csosborn/roboat/tools/README.md

# Deploy tools

Code reaches the boat only through git: commit on the laptop, then deploy that commit. Nothing is edited on the Pi or the RP2040 directly, so what's running is always an identifiable commit. The RP2040 reports its commit in every status message (the `rp2040_status` measurement in InfluxDB).

```bash
tools/deploy.sh            # deploy HEAD
tools/deploy.sh some-branch
tools/deploy.sh --no-flash # update the Pi but leave the RP2040 alone
tools/deploy.sh --flash    # reflash the RP2040 even if its files didn't change
```

Flashing resets the RP2040, but the Pi's power stays on through the reset (see the power safety rules in `Compute.md`). `deploy.sh` fails if the Pi rebooted during the deploy. (Until 2026-10-21 the Pi's supply dropped out during an RP2040 reset, and deploys used a `--flash-halt` option to shut the Pi down first; it's gone, because with the new supply a halted Pi would stay halted.)

`deploy.sh` runs `check.sh` (host tests plus a MicroPython compile of every firmware file), pushes the commit to the Pi's `deployed` branch over SSH, and runs `pi_apply.sh` there. That script:

- installs any systemd unit that differs from the installed copy, and reloads systemd;
- updates the monitor's virtualenv if its requirements changed, and restarts the monitor if its code or unit changed;
- runs `docker-compose up` if the TIG stack's configuration changed;
- flashes the RP2040 with `rp2040_flash.py` if `src/micro` changed. It flashes over the serial link that carries telemetry (`/dev/ttyAMA3`), stopping the monitor for the duration: the firmware's `maintenance` command moves its REPL onto that link. If the board doesn't respond, for example because its firmware predates serial deploys, it falls back to USB.

The flash stages every changed file on the RP2040 and verifies it before replacing anything, then resets the board and waits for its boot status message to report the new commit. If it fails part way, the board's files are unchanged; the interrupted firmware resumes on its own within 15 minutes, or immediately with a reset.

## Setting up a new RP2040

The firmware runs on stock MicroPython; no custom build is needed. Flash the release for the Adafruit Feather RP2040 (https://micropython.org/download/ADAFRUIT_FEATHER_RP2040/, currently v1.29.0) over USB: hold BOOTSEL while plugging it in, and copy the `.uf2` file to the drive that appears. `tools/requirements-dev.txt` pins `mpy-cross` to the same version, so `check.sh` compiles with the board's compiler; keep the two in step when upgrading.

A blank board has no firmware to answer the serial link's maintenance command, so its first install goes over USB, most easily from a laptop, before the board goes into the boat:

```bash
tools/.venv/bin/python tools/rp2040_flash.py --version "$(git rev-parse --short=12 HEAD)" --port /dev/cu.usbmodemXXXX --no-boot-check
```

Later deploys go over the serial link. MicroPython keeps the board's filesystem when it's reflashed, so a used board may still hold old files; they use up space the telemetry log needs, so check with `mpremote fs ls`.

## One-time Pi setup

The Pi's checkout at `~/roboat` must accept pushes to its checked-out branch, and refuse them if someone has edited files there:

```bash
git -C ~/roboat config receive.denyCurrentBranch updateInstead
git -C ~/roboat switch -c deployed
```

The secrets in `src/pi/TIG/*.env` stay on the Pi and are never deployed; see `src/pi/TIG/setup.md`.
