csosborn/roboat/take1/Navigation.md

# Roboat Navigation Module

## Hardware: GPS and IMU

GPS: [Adafruit MTK3339 Module](https://www.adafruit.com/product/790)

IMU: [Adafruit NXP 9-DOF IMU Module](https://www.adafruit.com/product/3463)

### Notes

The [TinyGPSPlus module](http://arduiniana.org/libraries/tinygpsplus/) ([v0.95](https://github.com/mikalhart/TinyGPSPlus/releases/tag/v0.95)) is used for parsing NMEA83 sentences from the GPS receiver.
