csosborn/roboat/take1/Pilot.md

# Roboat Pilot Module

## Hardware: Teensy 3.6

### Notes

The navigator module will need some help in the form of IMU sensor fusion. Consider using [the Madgwick AHRS algorithm](https://github.com/PaulStoffregen/MadgwickAHRS).
