csosborn/roboat/hardware/avionics/avionics.kicad_pcb

## KiCad design hardware/avionics/avionics.kicad_pcb (2026-11-11)

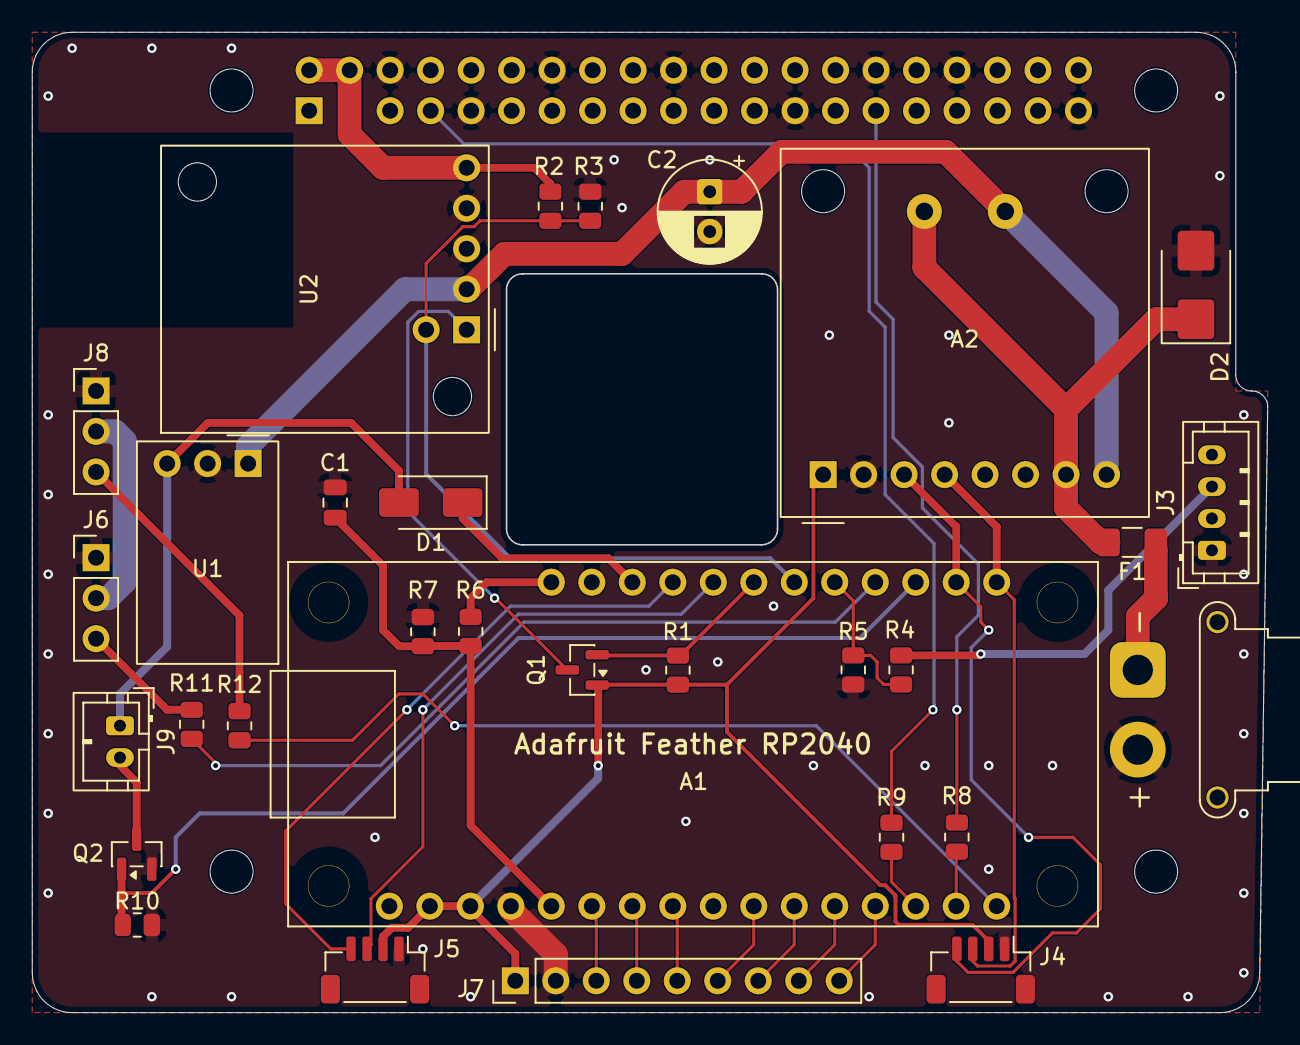
[picture p3: board avionics.kicad_pcb from above]

Board: 2 copper layers, 77.5 x 61.5 mm, 36 parts (1 on the bottom side), 37 nets.

Parts:
A1: Feather RP2040; Adafruit-Feather-RP2040
A2: INA260 breakout; Adafruit_INA260_Breakout
C1: 0.1u; C_0805_2012Metric
C2: 33u 50V; CP_Radial_D6.3mm_P2.50mm
D1: SS12; D_SMA
D2: SMBJ18A; D_SMB
F1: 0685T3000-01; Fuse_1206_3216Metric_Pad1.42x1.75mm_HandSolder
H1, H2, H3, H4: MountingHole_2.7mm_M2.5
J1: Load input; AMASS_XT30PW-F_1x02_P2.50mm_Horizontal
J2: Raspberry Pi header; PinSocket_2x20_P2.54mm_Vertical_NoPin3
J3: VE.Direct; JST_PH_B4B-PH-K_1x04_P2.00mm_Vertical
J4: STEMMA QT I2C1; JST_SH_BM04B-SRSS-TB_1x04-1MP_P1.00mm_Vertical
J5: STEMMA QT I2C0; JST_SH_BM04B-SRSS-TB_1x04-1MP_P1.00mm_Vertical
J6: ESC; PinHeader_1x03_P2.54mm_Vertical
J7: Spare GPIO; PinHeader_1x09_P2.54mm_Vertical
J8: Rudder servo; PinHeader_1x03_P2.54mm_Vertical
J9: Drive relay input; JST_PH_B2B-PH-K_1x02_P2.00mm_Vertical
Q1, Q2: BSS138; SOT-23
R1, R2, R4: 10k; R_0805_2012Metric
R3, R5: 15k; R_0805_2012Metric
R6, R7, R10: 100k; R_0805_2012Metric
R8, R9, R11, R12: 1k; R_0805_2012Metric
U1: D24V7F5; Pololu_D24V7F5
U2: D36V28F5; Pololu_D36V28F5

Connections:
/3V3: A1.2 (3.3V), A1.3 (3.3V), A2.1 (VCC), J4.2, J5.2, J7.1, Q1.1 (G), R1.1
/5V_AON: D1.2 (A), J9.1, U1.3 (VOUT)
/5V_PI: J2.2, J2.4, R2.1, U2.5 (VOUT)
/BEC_5V: J6.2, J8.2
/DRIVE_PWM: A1.20 (D6/GPIO8), R11.1
/DRIVE_PWM_R: J6.3, R11.2
/DRIVE_PWR_EN: A1.19 (D5/GPIO7), Q2.1 (G), R10.1
/DRIVE_RELAY_N: J9.2, Q2.3 (D)
/FEATHER_USB: A1.26 (Vbus), D1.1 (K)
/I2C0_SCL: A1.25 (D13/GPIO13), J5.4
/I2C0_SDA: A1.24 (D12/GPIO12), J5.3
/I2C1_SCL: A1.18 (SCL/GPIO3), A2.3 (SCL), J4.4
/I2C1_SDA: A1.17 (SDA/GPIO2), A2.4 (SDA), J4.3
/LIPO_BAT: A1.28 (VBat), R6.1
/LIPO_SENSE: A1.5 (A0/GPIO26), C1.1, R6.2, R7.1
/LOAD_FUSED: A2.7 (VIN+), D2.1 (K), F1.2
/LOAD_IN: F1.1, J1.1
/PI_EN: Q1.3 (D), U2.1 (EN)
/PI_EN_CTRL: A1.23 (D11/GPIO11), Q1.2 (S), R1.2
/PI_LINK_RX: A1.14 (RX/CS/GPIO1), R9.1
/PI_LINK_RX_R: J2.7, R9.2
/PI_LINK_TX: A1.15 (TX/GPIO0), R8.1
/PI_LINK_TX_R: J2.29, R8.2
/PI_PG: A1.22 (D10/GPIO10), R2.2, R3.1, U2.6 (PG)
/RUDDER_PWM: A1.16 (D4/GPIO6), R12.1
/RUDDER_PWM_R: J8.3, R12.2
/SPARE_A1: A1.6 (A1/GPIO27), J7.3
/SPARE_A2: A1.7 (A2/GPIO28), J7.4
/SPARE_A3: A1.8 (A3/GPIO29), J7.5
/SPARE_D25: A1.10 (D25/GPIO25), J7.6
/SPARE_MISO: A1.13 (MISO/GPIO20), J7.9
/SPARE_MOSI: A1.12 (MOSI/GPIO19), J7.8
/SPARE_SCK: A1.11 (SCK/GPIO18), J7.7
/VBUS_12V: A2.8 (VIN-), C2.1, U1.1 (VIN), U2.2 (VIN)
/VE_TX: J3.3, R4.1
/VE_TX_3V3: A1.21 (D9/GPIO9), R4.2, R5.1
GND: A1.4 (GND), A2.2 (GND), C1.2, C2.2, D2.2 (A), J1.2, J2.6, J2.9, J2.14, J2.20, J2.25, J2.30, J2.34, J2.39, J3.1, J4.1, J5.1, J6.1, J7.2, J8.1, Q2.2 (S), R3.2, R5.2, R7.2, R10.2, U1.2 (GND), U2.3 (GND1), U2.4 (GND2)
