csosborn/roboat/take1/hw/Roboat/RoboatCore.brd

## EAGLE design take1/hw/Roboat/RoboatCore.brd (2017-11-06)

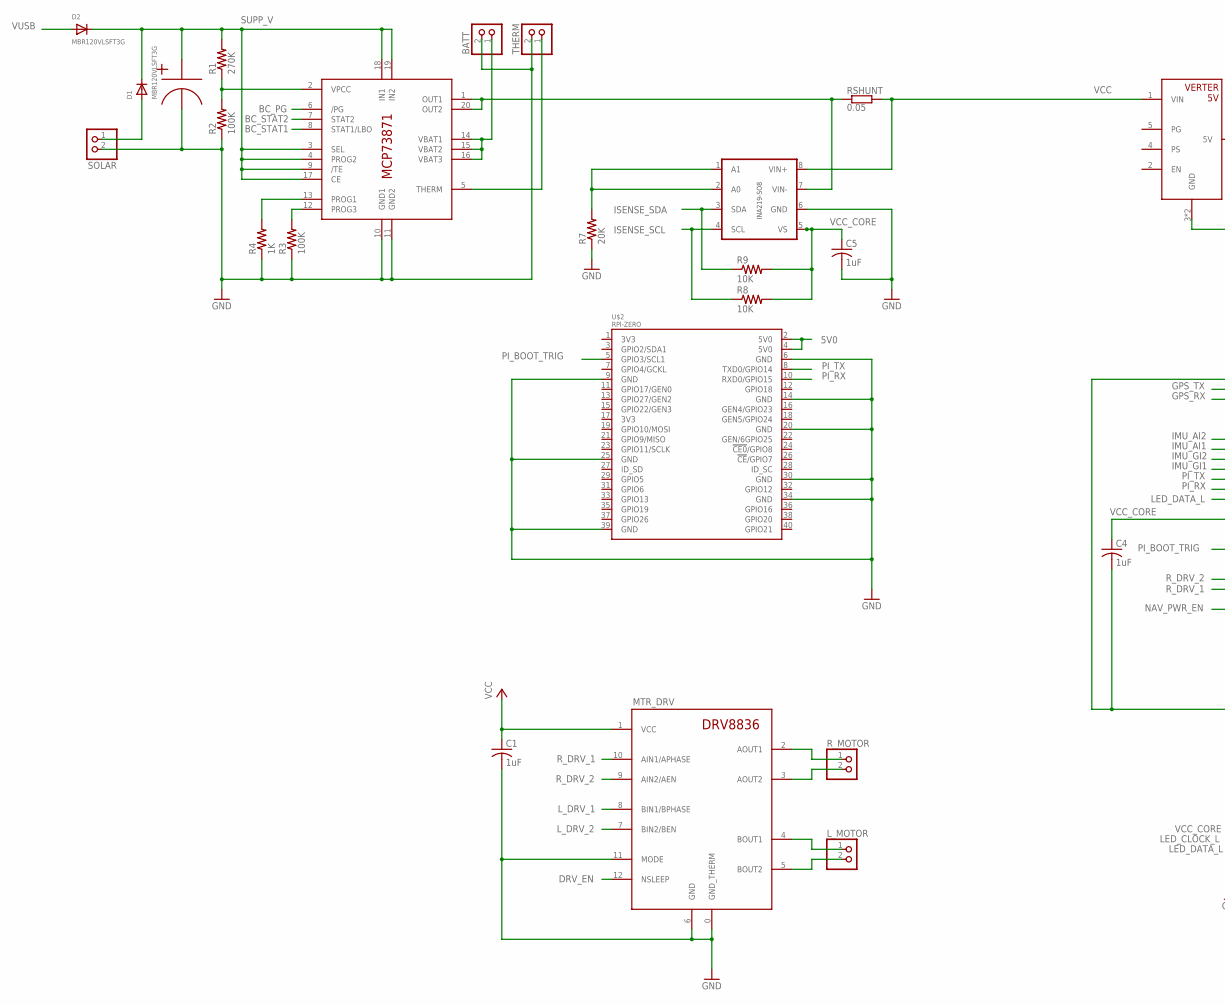
[picture p4: schematic RoboatCore.sch, part in row 1, column 1]

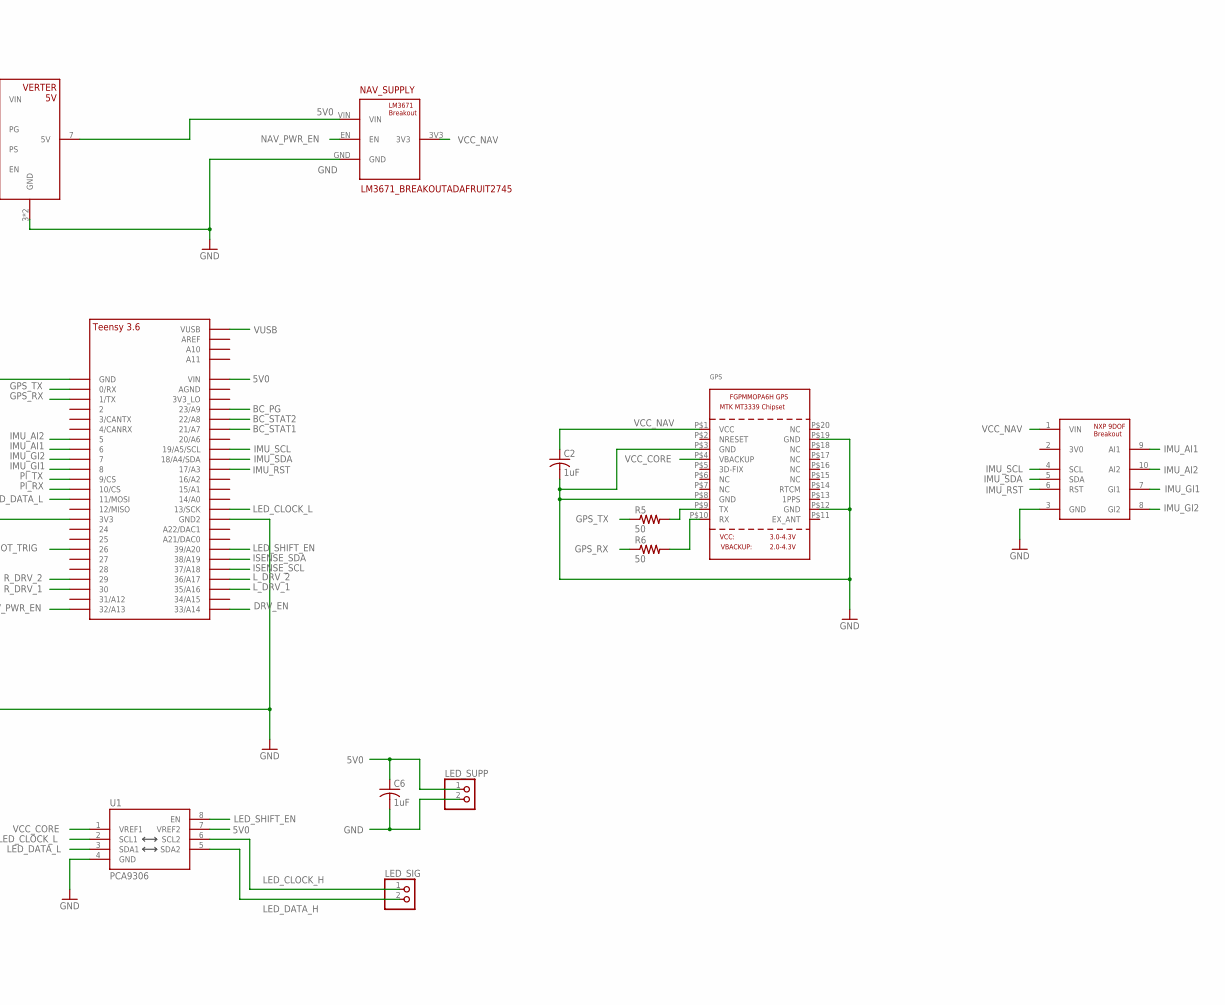
[picture p5: schematic RoboatCore.sch, part in row 1, column 2]

Parts:
BATT: JST_2PIN-SMT-RA; JST-PH-2-SMT-RA
C1, C2, C4, C5, C6: 1uF; C0603
C3: 2200uF; 2200UF_CAN
D1, D2: MBR120VLSFT3G; SOD-123
GPS: GPS_FGPMMOPA6H; FGPMMOPA6H
IC2: MCP73871; QFN20
INA219: INA219-SO8D; SO08
LED_SIG: PINHD-1X2; 1X02
LED_SUPP: PINHD-1X2; 1X02
L_MOTOR: PINHD-1X2; 1X02
MTR_DRV: DRV8836DRV8836DSSR; WSON-12
NAV_SUPPLY: LM3671_BREAKOUTADAFRUIT2745; LM3671_BREAKOUT
R1: 270K; R0603
R2, R3: 100K; R0603
R4: 1K; R0603
R5, R6: 50; R0603
R7: 20K; R0603
R8, R9: 10K; R0603
RSHUNT: 0.05; SMK
R_MOTOR: PINHD-1X2; 1X02
SOLAR: JST_2PIN-SMT-RA; JST-PH-2-SMT-RA
THERM: JST_2PIN-SMT-RA; JST-PH-2-SMT-RA
U1: PCA9306; PSOP-8
U$1: TEENSY_3.5/3.6_BASIC
U$2: RPI-ZERO; RASP_PI_ZERO_BOARD_FULL
U$3: NXP_9DOF_BREAKOUTADAFRUIT3463; NXP_9DOF_BREAKOUT
U$4: VERTER_5VADAFRUIT2190; VERTER_5V

Connections:
5V0: C6.1, LED_SUPP.1, NAV_SUPPLY.VIN, U1.7 (VREF2), U$1.VIN, U$2.2 (5V0), U$2.4 (5V0), U$4.7 (5V)
BATT_NTC: IC2.5 (THERM), THERM.1 (2)
BC_PG: IC2.6 (/PG), U$1.23/A9
BC_STAT1: IC2.8 (STAT1/LBO), U$1.21/A7
BC_STAT2: IC2.7 (STAT2), U$1.22/A8
DRV_EN: MTR_DRV.12 (NSLEEP), U$1.33/A14
GND: BATT.2 (1), C1.2, C2.2, C3.2 (NEG), C4.2, C5.2, C6.2, GPS.P$3 (GND), GPS.P$8 (GND), GPS.P$12 (GND), GPS.P$19 (GND), IC2.10 (GND1), IC2.11 (GND2), INA219.6 (GND), LED_SUPP.2, MTR_DRV.0 (GND_THERM), MTR_DRV.6 (GND), MTR_DRV.11 (MODE), NAV_SUPPLY.GND, R2.1, R3.1, R4.1, R7.1, SOLAR.2 (1), THERM.2 (1), U1.4 (GND), U$1.GND, U$1.GND2, U$2.6 (GND), U$2.9 (GND), U$2.14 (GND), U$2.20 (GND), U$2.25 (GND), U$2.30 (GND), U$2.34 (GND), U$2.39 (GND), U$3.3 (GND), U$4.3 (GND), U$4.6 (GND)
GPS_RX: R6.1, U$1.1/TX
GPS_RX_I: GPS.P$10 (RX), R6.2
GPS_TX: R5.1, U$1.0/RX
GPS_TX_O: GPS.P$9 (TX), R5.2
IMU_AI1: U$1.6, U$3.9 (AI1)
IMU_AI2: U$1.5, U$3.10 (AI2)
IMU_GI1: U$1.8, U$3.7 (GI1)
IMU_GI2: U$1.7, U$3.8 (GI2)
IMU_RST: U$1.17/A3, U$3.6 (RST)
IMU_SCL: U$1.19/A5/SCL, U$3.4 (SCL)
IMU_SDA: U$1.18/A4/SDA, U$3.5 (SDA)
ISENSE_SCL: INA219.4 (SCL), R8.1, U$1.37/A18
ISENSE_SDA: INA219.3 (SDA), R9.1, U$1.38/A19
LED_CLOCK_H: LED_SIG.1, U1.6 (SCL2)
LED_CLOCK_L: U1.2 (SCL1), U$1.13/SCK
LED_DATA_H: LED_SIG.2, U1.5 (SDA2)
LED_DATA_L: U1.3 (SDA1), U$1.11/MOSI
LED_SHIFT_EN: U1.8 (EN), U$1.39/A20
L_DRV_1: MTR_DRV.8 (BIN1/BPHASE), U$1.35/A16
L_DRV_2: MTR_DRV.7 (BIN2/BEN), U$1.36/A17
unnamed: MTR_DRV.2 (AOUT1), R_MOTOR.1
unnamed: MTR_DRV.3 (AOUT2), R_MOTOR.2
unnamed: IC2.2 (VPCC), R1.1, R2.2
unnamed: L_MOTOR.1, MTR_DRV.4 (BOUT1)
unnamed: L_MOTOR.2, MTR_DRV.5 (BOUT2)
unnamed: INA219.1 (A1), INA219.2 (A0), R7.2
unnamed: BATT.1 (2), IC2.14 (VBAT1), IC2.15 (VBAT2), IC2.16 (VBAT3)
unnamed: IC2.12 (PROG3), R3.2
unnamed: IC2.13 (PROG1), R4.2
NAV_PWR_EN: NAV_SUPPLY.EN, U$1.32/A13
PI_BOOT_TRIG: U$1.26, U$2.5 (GPIO3/SCL1)
PI_RX: U$1.10/CS, U$2.10 (RXD0/GPIO15)
PI_TX: U$1.9/CS, U$2.8 (TXD0/GPIO14)
R_DRV_1: MTR_DRV.10 (AIN1/APHASE), U$1.30
R_DRV_2: MTR_DRV.9 (AIN2/AEN), U$1.29
SOLAR_V_RAW: D1.A, SOLAR.1 (2)
SUPP_V: C3.1 (POS), D1.C, D2.C, IC2.3 (SEL), IC2.4 (PROG2), IC2.9 (/TE), IC2.17 (CE), IC2.18 (IN1), IC2.19 (IN2), R1.2
VBUS: IC2.1 (OUT1), IC2.20 (OUT2), INA219.7 (VIN-), RSHUNT.2
VCC: C1.1, INA219.8 (VIN+), MTR_DRV.1 (VCC), RSHUNT.1, U$4.1 (VIN)
VCC_CORE: C4.1, C5.1, GPS.P$4 (VBACKUP), INA219.5 (VS), R8.2, R9.2, U1.1 (VREF1), U$1.3V3
VCC_NAV: C2.1, GPS.P$1 (VCC), NAV_SUPPLY.3V3, U$3.1 (VIN)
VUSB: D2.A, U$1.VUSB

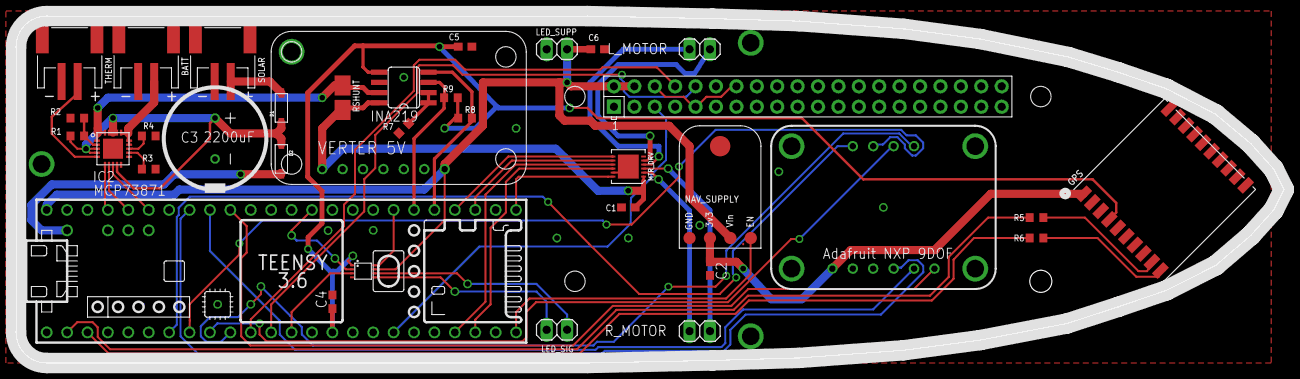
[picture p6: board RoboatCore.brd from above]

Board: 2 copper layers, 157.8 x 43.2 mm, 35 parts (0 on the bottom side), 49 nets.
