csosborn/roboat/(commit log)

2017-09-11 First commit, with notes and initial Arduino code skeleton.
2017-11-06 Added PCB and related Eagle libraries.
    [RoboatCore.brd, RoboatCore.sch]
2017-11-06 Updated Arduino code with new pin assignments from PCB.
    [RoboatCore.sch]
2017-12-24 Added PowerManager state machine to Pilot module.
2017-12-26 Rearranged initializer lists to avoid reorder warnings
    [Pilot.ino]
2024-10-24 Move abandoned prehistory to take1 directory.
    [RoboatCore.brd, RoboatCore.sch]
2024-12-02 Some updated notes on the power control state machine.
2026-10-11 Tidy .gitignore and untrack stray files.
    Fix the long-standing '.vscodedesktop' typo, drop stale take1-era entries,
    and add patterns for Python caches, node_modules, env files, and KiCad
    backups/caches. Untrack a committed .DS_Store and fold the TIG-local
    gitignore into the root one.
2026-10-11 Add spreader plug STL.
2026-10-11 Commit the RP2040 firmware files actually running on the device.
    roboat_fsm.py, pi_link.py, and victron.py on the RP2040 had diverged from
    git; the device's roboat_fsm.py is the one that drives the power pins and
    that main.py's RoboatSM(...) call matches. Copied from the device on
    2026-10-10.
2026-10-11 Keep the Pi powered across RP2040 resets and make the firmware recoverable.
    - boot.py drives the Pi relay high before anything else runs; startup no
    longer switches the Pi off. Init now waits for the first battery reading,
    and a Pi found running stays running (AwaitPower -> NoPiComms).
    - Power monitoring moves to power_monitor.py: sensor errors are counted and
    survived (the INA260 bus is rebuilt after repeated failures), the first
    MPPT frame and frames without a battery voltage are ignored (a partial
    frame used to read as 0 V), the INA260 stands in when the MPPT is stale,
    and main power has hysteresis.
    - supervisor.py: watchdog fed only while the main loop runs, Ctrl-C opens a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
2026-10-11 Document the power safety rules and the updated power state machine.
    Also correct the USB link: it carries data only, and its VBUS line must be
    cut so it can't back-power the Pi.
2026-10-11 Keep the Pi off after a cold start; restore its last state after a crash.
    A power-on reset can mean the whole system is waking at dawn on a nearly
    empty battery, so boot.py now leaves the Pi off and lets the FSM's energy
    rules start it, instead of starting it on every boot. A watchdog reset
    (crash, hang, or deploy) restores the relay state the firmware last chose
    deliberately, recorded in a pi_power file on each change. A soft reset
    leaves the relay alone. The policy lives in power_policy.py and is tested.
    Safe mode now leaves the relay as boot.py set it instead of forcing the Pi
    on, and retries normal operation after an hour.
2026-10-11 Add deploy tooling for the Pi and the RP2040.
    tools/deploy.sh checks a commit (host tests and a MicroPython compile of the
    firmware), pushes it to the Pi's checkout, and runs tools/pi_apply.sh there,
    which installs changed systemd units, updates and restarts the monitor,
    updates the TIG stack, and flashes the RP2040 when its files changed.
    tools/rp2040_flash.py stages each changed file on the RP2040 and verifies its
    SHA-256 before replacing anything, removes files a previous deploy shipped,
    resets the board, and confirms the new commit from the boot status message.
2026-10-11 Give the monitor its own InfluxDB token file.
    Telegraf's token in telegraf.env is a different token from the one the
    monitor has been using, and may not be able to write the monitor's
    roboat_01 bucket. The monitor now loads INFLUX_TOKEN from a gitignored
    src/pi/monitor/monitor.env instead.
2026-10-11 Flash safely while an RP2040 reset still cuts the Pi.
    Measurements show the 10k pull-up doesn't hold the Pi's relay on through an
    RP2040 reset, so a flash that resets the board would cut a running Pi.
    - tools/deploy.sh --flash-halt flashes the RP2040 with a delayed reset,
    shuts the Pi down cleanly, and waits for the reset to power-cycle the
    halted Pi back up and for the RP2040 to report the new commit.
    - The firmware also reconnects USB after boot whenever the Pi is powered,
    since the Pi may be booting at the same time and miss the board.
    - Compute.md no longer claims the pull-up holds the relay on.
2026-10-11 Use SSH keepalives while waiting for the Pi to come back.
    A connection opened just before the Pi powered off hung until the deploy's
    deadline, so a successful --flash-halt was reported as a failure.
2026-10-11 Move the GPS to the RP2040 and timestamp telemetry with GPS time.
    RP2040:
    - gps.py reads the Adafruit Mini GPS (PA1010D) over I2C1, configures it to
    send only RMC, GGA, and GSA (and re-sends that if the module forgets it),
    and reports a gps message on each fix. nmea.py parses those sentences.
    Coordinates travel as integer 1e-7 degrees, since RP2040 floats are 32-bit.
    - clock.py keeps GPS-disciplined UTC as integer milliseconds. Every message
    carries utc_ms once the time is known.
    - The INA260 and the GPS share one I2C bus object (shared_bus.py), so a bus
    rebuild after INA260 errors reaches both.
    - Status messages now report GPS health, time validity, I2C rebuilds, and
    the outcome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
2026-10-11 Fix the USB reconnect, which left USB switched off.
    The first use of machine.USBDevice takes over from the boot-time USB stack
    with no built-in driver, so the reconnect's active(True) failed and USB,
    including the REPL, stayed off until a reset. Restore the built-in driver
    before reactivating. A test models that behaviour.
    Also:
    - rp2040_flash.py takes --port and --wait, so it can run from a laptop and
    catch the board just after it resets.
    - Test fakes move out of conftest.py, whose name clashed between the
    firmware and Pi test directories.
2026-10-11 Run delayed work from the main loop instead of one-shot Timers.
    On the RP2040, a machine.Timer that nothing references can be
    garbage-collected before it fires, which cancels it. The firmware's USB
    reconnects (and the FSM's shutdown timeout) were scheduled that way and
    never ran. scheduler.py now runs delayed and periodic work from the main
    loop. The watchdog feeder, which must keep running during maintenance,
    stays a hardware Timer with a permanent reference.
2026-10-11 Remove the automatic USB reconnect.
    Tested by hand on the board: with this MicroPython build, USBDevice's
    active(False) disconnects, but active(True) after restoring the built-in
    driver doesn't bring USB back, so USB (and the REPL) stays off until a
    reset. Reconnecting this way isn't safe; another approach is needed for a
    Pi that boots after the RP2040.
2026-10-11 Flash the RP2040 over the Pi link's serial port.
    The firmware now reads one-line JSON commands from the Pi. A maintenance
    command stops the main loop (holding the watchdog off, as Ctrl-C does) and
    moves the REPL onto the UART with os.dupterm, so the deploy can use the
    same raw-REPL protocol it uses over USB. Safe mode attaches the REPL to the
    UART straight away. Lines containing noise are discarded whole, since the
    RP2040 sees noise while the Pi is off. The UART gets a 4 KB receive buffer
    because the link has no flow control.
    rp2040_flash.py --serial stops the monitor (which owns the port) while it
    flashes and restarts it before checking the boot status. pi_apply.sh tries
    serial first and f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
2026-10-12 Monitor: heartbeats with acks, replay handling, and GPS time for chrony.
    - The monitor sends {"cmd": "hb", "ack": N} every 2 s, where N is the
    highest replayed sequence number written to InfluxDB. The write queue
    tracks it, so a record is acknowledged only once it's stored.
    - Lines are timestamped on arrival (the loop no longer sleeps 100 ms
    between reads), and each live GPS fix becomes a sample for chrony's SOCK
    refclock (timesync.py). src/pi/etc/chrony/conf.d/roboat.conf adds that
    refclock, weighted so internet NTP wins when it's reachable.
    - pi_apply.sh installs anything under src/pi/etc, not only systemd units,
    and restarts chrony when its configuration changes.
    Co-Authored-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
2026-10-12 Calibrate the GPS refclock's constant lag (442 ms).
    Measured against internet NTP with chrony's sourcestats: +442 ms, standard
    deviation 17 ms.
2026-10-12 Keep a firmware that fails at startup reachable over serial.
    The firmware moves from main.py to app.py, and main.py becomes a guard
    that imports it. If anything fails before the firmware is running, the
    guard reports a startup_failed status to the Pi, logs the crash, and moves
    the REPL onto the Pi link's UART, so a serial deploy can repair it without
    a USB cable. Until now, such a failure left the REPL reachable only over
    USB.
2026-10-12 Document the startup guard in the power safety rules.
2026-10-12 Shut the Pi down cleanly when the battery runs low.
    Once the battery has stayed below 12.8 V for 2 minutes (roughly 15-20%
    charge for LiFePO4 at the boat's loads), the FSM goes from PiAlive or
    NoPiComms to PiStopping. The RP2040 asks the Pi to power off over the UART,
    repeating every 5 s; the monitor runs systemctl poweroff on a live request
    (never a replayed one). Once the Pi has been silent for 30 s past the
    heartbeat timeout, or after 2 minutes regardless, the RP2040 cuts its power
    and moves to AwaitPower. The hard cut below 12.4 V remains as the failsafe.
    The Pi is restarted only when energy is OK and the battery is at least
    13.0 V, and not within 15 minutes of a deliberate shutdown, so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
2026-10-12 Retry flash steps after a corrupted byte on the serial link.
    The UART link shows occasional framing errors (54 in 15 minutes on the
    Pi's side). One dropped a raw-REPL marker and aborted a flash. Each step
    now re-enters the raw REPL and retries, up to three times; restaging a
    file starts it over, and installing skips files already moved into place.
    Staged files are still verified by hash, so a retry can't leave corrupted
    data on the board.
2026-10-12 Record the 20 Ah battery now in use.
2026-10-12 Record the Victron load output thresholds (off < 12.0 V, on > 13.2 V).
2026-10-14 Keep about 55 hours of telemetry while the Pi is off, and never drop events.
    The 2 MB log held only about 14 hours of 30-second snapshots (about 1.2 KB
    each), so the 2026-10-13 low-battery test lost the first 4.6 hours after the
    shutdown, including the pi_power_cut event.
    - Snapshot every 60 s instead of 30, and don't store a sensor message again
    if it hasn't changed since the last snapshot.
    - Cap the log at 4 MB, and drop old segments whenever flash free space falls
    below 1 MB, so a deploy can always stage new firmware.
    - When the oldest segment is dropped, record its event records again at the
    end of the log. They keep their utc_ms, so InfluxDB files them in order.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
2026-10-15 Don't count main power as up while the MPPT's load output is off.
    On 2026-10-14 the battery recovered on solar to 13.0 V, and the RP2040
    started the Pi. The Victron only reconnects its load output above 13.2 V,
    so the relay closed on a dead supply, while the RP2040 ran on its LiPo.
    Main power now also needs the load output to be live: the Victron's LOAD
    field isn't OFF, and the INA260 (on the load side) doesn't read below 9 V.
    An MPPT that never reports LOAD doesn't block it.
2026-10-15 Record what the October discharge test taught us about the battery.
    docs/battery/ holds the write-up, the one-minute telemetry from 2026-10-11
    to 10-15 (a full discharge to the Victron's 12.0 V load cut-off and a
    recharge to full), and the scripts that export and summarize it.
    Main findings: about 18.8 Ah usable at light load (94% of the rating), with
    charge in and out agreeing within 1%; a nearly flat curve from about 90% to
    15%; reliable landmarks at full, at a plateau step near 57%, and in the final
    knee below about 12.7 V. The Pi's 12.8 V shutdown leaves about 13%.
2026-10-22 Store every event on flash as well as sending it.
    On 2026-10-21 a battery disconnect cut the Pi's power at once. The RP2040
    reported pi_power_cut while it still thought the Pi was listening (the
    heartbeat timeout is 10 s), so the event was only sent live, into a Pi
    that was already off, and never recorded.
    Events now always go to the flash log too, and the boot, pi_up,
    maintenance and crash events use the same path. Replaying a record the
    Pi already has is harmless: InfluxDB keeps one point per timestamp.
2026-10-22 Retire --flash-halt: the Pi's power now rides through an RP2040 reset.
    The Pi's supply is now a Pololu D36V28F5 whose EN is switched from GPIO11
    through a BSS138 level shifter. The shifter's pull-up holds the pin high
    while the RP2040 is in reset, so the supply stays on. A deploy on
    2026-10-21 reset the RP2040 without the Pi rebooting.
    --flash-halt shut the Pi down and relied on the reset to power-cycle it.
    With the new supply a halted Pi would stay halted, so the option is gone,
    along with rp2040_flash.py's --reset-delay. deploy.sh now fails if the Pi
    rebooted during a deploy. Compute.md describes the new supplies, and the
    code comments no longer talk about a relay.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
2026-10-26 Read the LiPo voltage, the Pi supply's power-good, and the new IMU's presence.
    Wiring added 2026-10-26:
    - LiPo: the Feather's BAT pin through a 100k/100k divider to A0 (GPIO26).
    Reported as lipo_v, the mean of 16 readings per status.
    - The Pi supply's PG output: GPIO10, through a divider fed by the supply's
    own 5 V, so it's high only while the Pi has good power. A pi_supply_fault
    event is reported if it stays low for 3 s while the Pi should be on.
    - IMU: an Adafruit BNO085 on the STEMMA QT chain at 0x4A, replacing the
    LSM9DS1 on I2C0. Only its presence is checked (imu_present); I2C0 is
    no longer set up, which frees GPIO 12/13.
    Also move UART1's TX (unused: the Victron only transmi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
2026-10-27 Run on stock MicroPython: drop the ulab SoC estimator, and move to 1.29.
    The RP2040 Feather is being replaced after its 3.3 V regulator failed.
    The only thing that needed a custom MicroPython build (with ulab) was
    LFPSoCEstimator, an estimate the battery characterization found poor.
    It's removed; the battery message's soc now comes from BatteryModel's
    charge estimate, so the InfluxDB fields stay the same.
    The new board will run stock MicroPython 1.29.0, which still has
    os.dupterm (needed for serial deploys) on rp2. check.sh's mpy-cross
    moves to the same version. tools/README.md describes setting up a
    new board, including its first deploy over USB.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
2026-11-05 Allow flashing a new board from a laptop.
    rp2040_flash.py's boot check reads the monitor's journal, which only
    exists on the Pi. --no-boot-check skips it, so a blank board can get its
    first install over USB on the bench, with no USB cable needed on the Pi.
2026-11-05 Record the divider on the Victron's 5 V TX line.
2026-11-05 Require power-good to hold for 3 s before reporting a change.
    The 3 s delay only ran from power-on, so once past it any brief low on
    PG was a fault and any high a recovery. On 2026-11-05 a disturbed wire
    produced 551 events in under two minutes, each one written to flash.
    A change must now hold for the full delay, in either direction.
2026-11-06 Calibrate the LiPo reading against a multimeter.
2026-11-06 Add the avionics board's connection list and first-draft schematic.
    The protoboard's wiring is causing faults, so the electronics are moving
    to a custom PCB. connections.md is the reference for every net; the draft
    schematic is generated from it, and check_netlist.py compares KiCad's
    netlist with it after each edit.
2026-11-06 Note that the firmware now stops the ESC signal with the relay.
2026-11-06 Stop the ESC signal whenever the drive relay goes off.
    Losing main power cut the relay but left the signal at 1.5 ms, pulsing
    into an unpowered ESC, which can back-power it through the signal pin.
    Arming also ran 7 s after the relay came on, so a power loss in that
    window set the signal after the relay had already gone off.
2026-11-09 Start the avionics board's layout, stacked on the Pi 4.
    - Add the PCB, with the Pi 4 drawn beneath it (outline, parts, mounting
    holes H1-H4, J2 on the Pi's header, a cutout above the CPU) by
    tools/add_pi4_outline.py, from Raspberry Pi's mechanical drawing.
    - Generate footprints for the INA260 breakout and the two Pololu
    regulators (tools/generate_footprints.py), with a model for the INA260;
    tools/fetch_3d_models.sh downloads the STEP models, which stay out of git.
    - Choose D1 (SS12) and F1 (Bel 0685T3000-01, 1206 slow-blow) in
    connections.md and the schematic.
    - Tidy the schematic; ERC is clean and check_netlist.py finds no
    differences from connections.md.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
2026-11-11 Keep records made before the GPS gives the time.
    The RP2040 has no clock of its own, so until the GPS's first fix its records
    carry no utc_ms and were dropped, only counted in log_unstorable. After a cold
    start that's the first minutes: on 2026-11-10 the first fix took 2 min 14 s,
    and 11 records were lost, including the boot event and the whole stretch on
    main power. Those are the minutes a dawn wake most needs on record.
    They're now held in RAM (untimed.py, up to 12 KB, about 8 minutes of
    snapshots), stamped with ticks_ms, and stored once the clock knows the time,
    with utc_ms counted back from the fix. Past the limit the oldest non-event
    records go first. log_unstorable now counts only tho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
2026-11-11 Set the clock only from current GPS time, and hold records 3 s.
    Deploying #17 showed two boot events 11 s apart. Two causes:
    - The PA1010D buffers what it sends while nobody reads. After the RP2040
    resets, the first sentences read are seconds old, and every RMC set the
    clock, so it started about 10 s behind until the backlog was read. That
    skewed anything stamped in the first seconds after a reset (and #17's
    back-stamped records), and fed chrony a few stale samples. The clock is now
    set only from the last RMC read before the module returns padding, which
    shows its buffer is empty and that RMC current.
    - The GPS was quick enough after the reset that the held boot event was stored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
2026-11-11 Route the avionics board, with ground pours on both sides.
    - Every net routed (236 tracks, 55 vias). GND is a pour on F.Cu and B.Cu
    (zone clearance 0.2 mm), tied together by 43 stitching vias.
    - Power net class (the battery-side nets, 5V_PI, BEC_5V and GND): 1.5 mm
    tracks, 0.2 mm clearance, 0.8/0.4 mm vias. Light offshoots use thinner
    tracks.
    - J2 has no pin 3 (the Pi's GPIO2/I2C1 SDA, which this board doesn't use), so
    5V_PI can reach pins 2 and 4 from both sides of the inner row. Its contact is
    pushed out of the socket before soldering. New symbol
    roboat:Pi_Header_2x20_NoPin3 and footprint
    roboat:PinSocket_2x20_P2.54mm_Vertical_NoPin3, both made by
    generate_footprints.py fro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
